Marwanthe0/smart-aquaculture-edge-ai/(commit log)

2026-09-04 Add DSP exponential moving average low-pass filter for analog sensor noise reduction and moved the engineeering guide document to docs section
    [esp_code.ino]
2026-09-04 Integrate on-device TinyML inference and autonomous edge fail-safe aeration control
    [esp_code.ino]
